nemanjan00/saleae-case/(commit log)

2026-09-24 Saleae Logic Pro 8 case with captive micro-USB 3.0 plug, and radius gauge
    Two-part case split through the USB plug center, M2x12 screws (4 corners +
    2 at the USB shroud), probe opening, engraved channel labels, LED and logo
    windows. Radius gauge used to measure device corners.
    [radius_gauge.scad, saleae_pro8_case.scad]
2026-09-24 Device corner radius 12 mm (measured), LED offset decoupled at 10 mm
    [saleae_pro8_case.scad]
2026-09-24 Fix roof thickness: pocket was 1 mm too tall, leaving a 1 mm roof
    [saleae_pro8_case.scad]
2026-09-24 Remove channel labels, device is square (54.62), 0.2 mm gap between device face and USB overmold
    [saleae_pro8_case.scad]
2026-09-24 LED 2 mm further from edges (12 mm); top logo window enlarged to 36 mm to include LED
    [saleae_pro8_case.scad]
2026-09-24 Probe opening clearance 0.4 mm per side
    [saleae_pro8_case.scad]
2026-09-24 USB overmold pocket 0.3 mm longer
    [saleae_pro8_case.scad]
2026-09-24 Document cable grip collar formed by pocket end and exit hole
    [saleae_pro8_case.scad]
2026-09-25 USB overmold pocket 0.2 mm longer (usb_clear_len 0.6)
    [saleae_pro8_case.scad]
2026-09-25 Add Makefile for STL generation
